AndresMartinM/trebuchet-udd/img/treb02.jpg

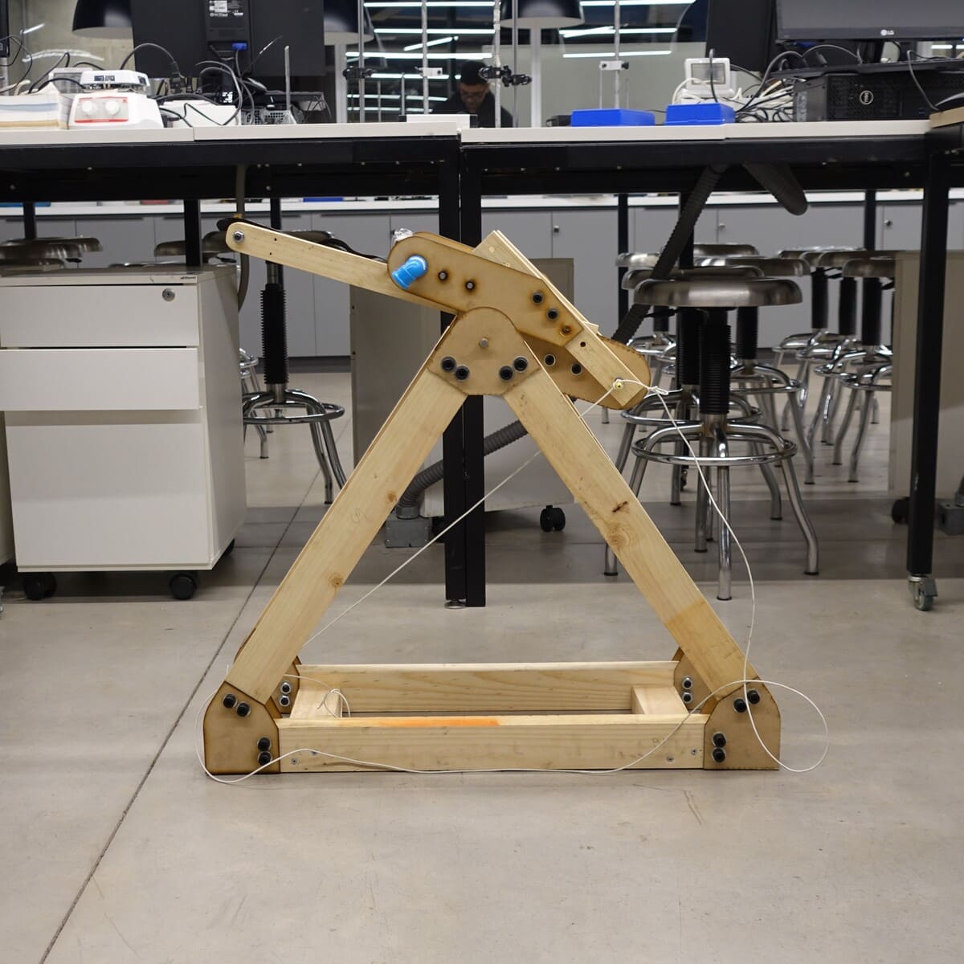
img/treb02.jpg
