AndresMartinM/trebuchet-udd/img/treb03.jpg

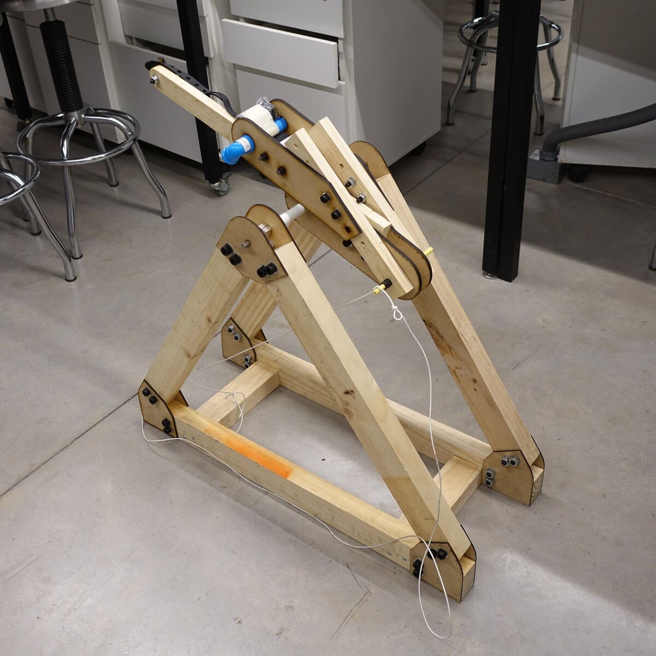
img/treb03.jpg
