AndresMartinM/trebuchet-udd/img/treb04.jpg

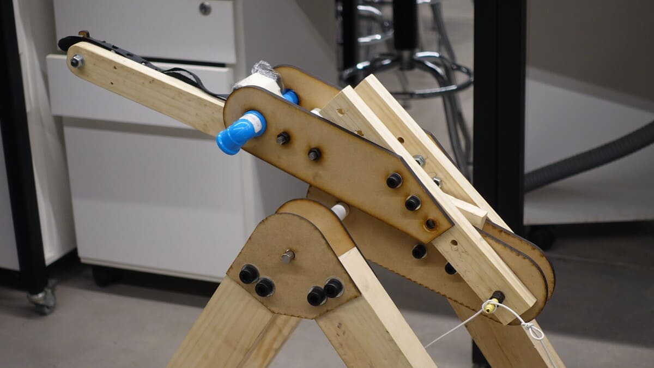
img/treb04.jpg
