AndresMartinM/trebuchet-udd/img/treb05.jpg

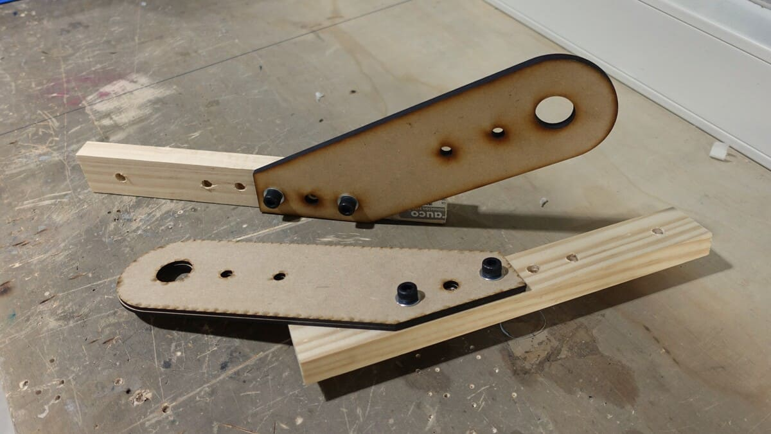
img/treb05.jpg
