AndresMartinM/trebuchet-udd/img/treb06.jpg

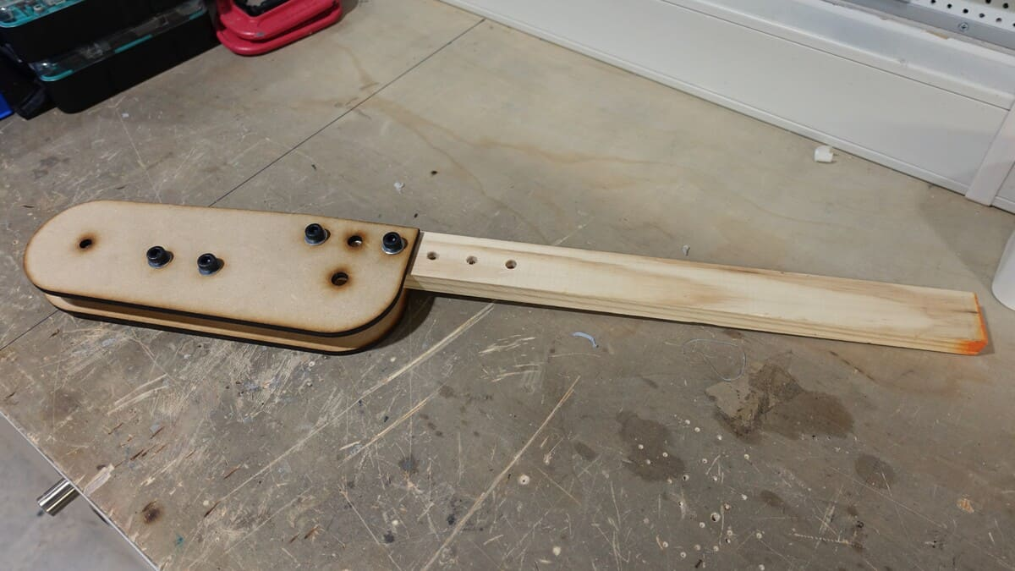
img/treb06.jpg
