AndresMartinM/trebuchet-udd/img/treb07.jpg

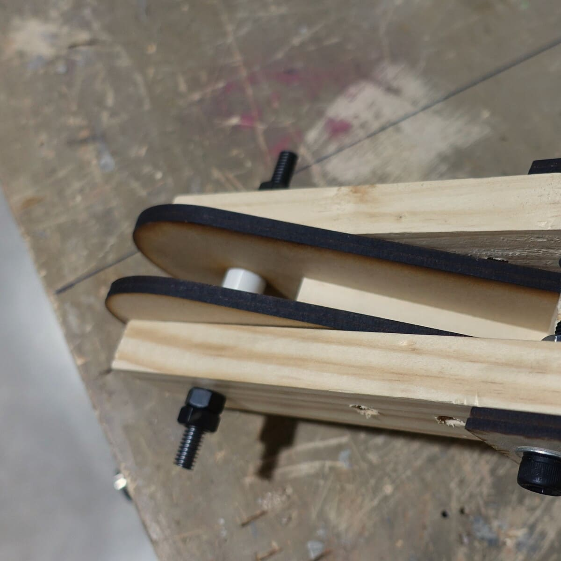
img/treb07.jpg
