AndresMartinM/trebuchet-udd/img/treb08.jpg

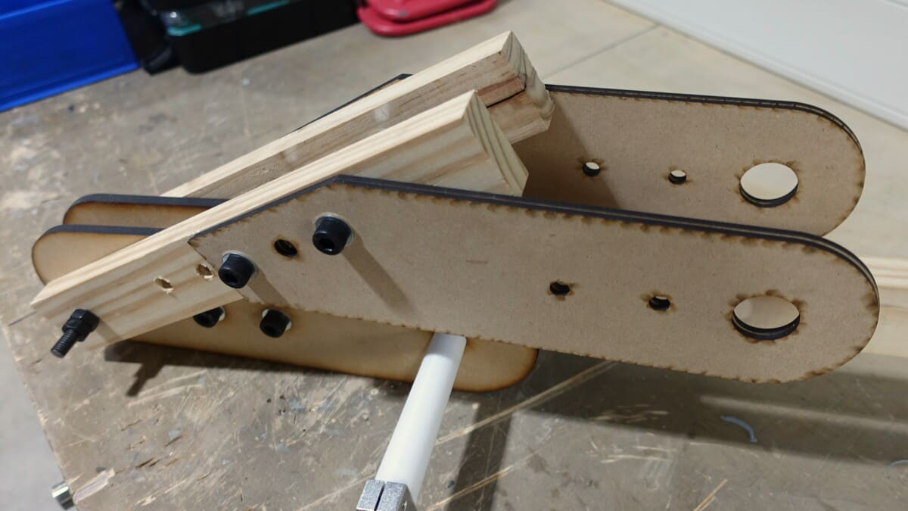
img/treb08.jpg
