AndresMartinM/trebuchet-udd/img/treb09.jpg

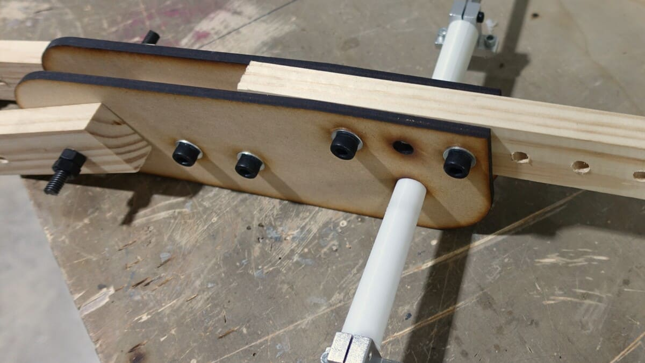
img/treb09.jpg
