AndresMartinM/trebuchet-udd/archivos/cabezalLanzador-1xCatapulta-3Total.stl

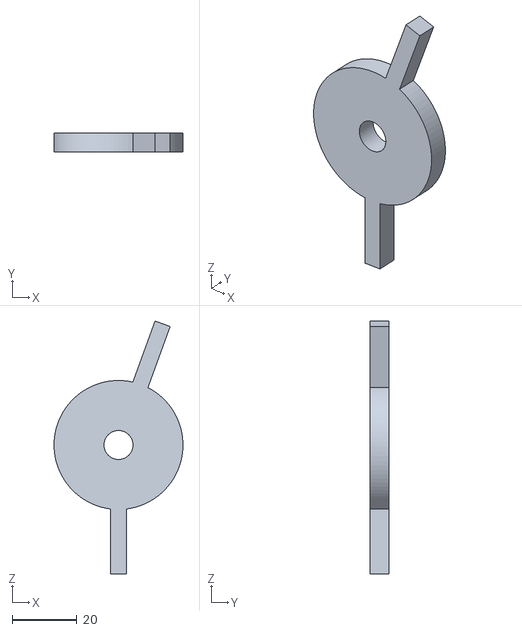
[picture p10: CAD file, 2025-05-27]
archivos/cabezalLanzador-1xCatapulta-3Total.stl
40.0 x 6.00 x 78.4
