AndresMartinM/trebuchet-udd/archivos/CORREGIDOunionSuperiorBaseCatapulta-MDF3mm-8xCatapulta-24Total.dxf

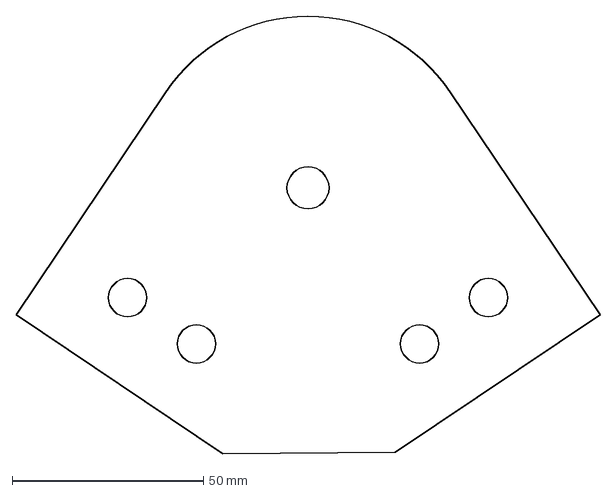
[picture p11: CAD file, 2025-05-27]
archivos/CORREGIDOunionSuperiorBaseCatapulta-MDF3mm-8xCatapulta-24Total.dxf
152.5 x 114.2 mm
