AndresMartinM/trebuchet-udd/archivos/unionBrazoContrapeso-MDF3mm-4xCatapulta-12Total.dxf

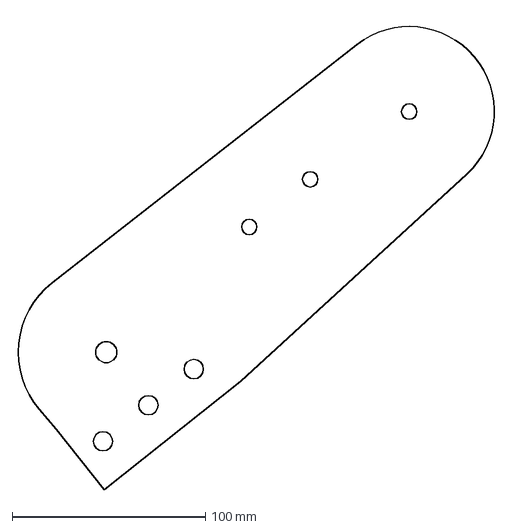
[picture p12: CAD file, 2025-05-27]
archivos/unionBrazoContrapeso-MDF3mm-4xCatapulta-12Total.dxf
252.0 x 244.7 mm
