AndresMartinM/trebuchet-udd/archivos/contrapesoCatapulta-MDF3mm-4xCatapulta-12Total.dxf

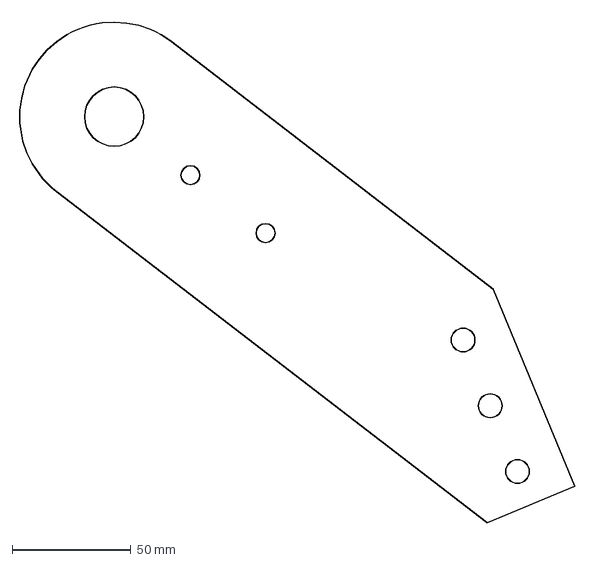
[picture p13: CAD file, 2025-05-27]
archivos/contrapesoCatapulta-MDF3mm-4xCatapulta-12Total.dxf
235.6 x 213.4 mm
