AndresMartinM/trebuchet-udd/archivos/CORREGIDOunionInferiorBaseCatapulta-MDF3mm-16xCatapulta-48Total.dxf

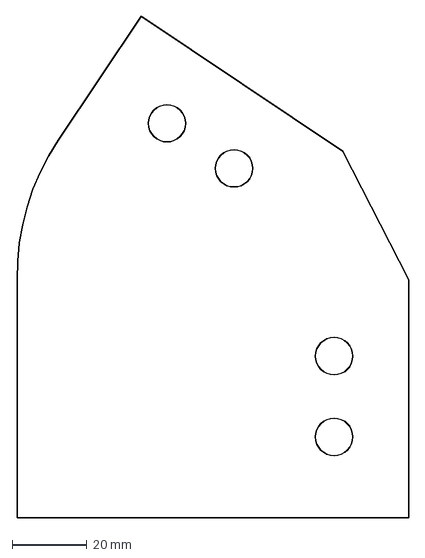
[picture p14: CAD file, 2025-05-27]
archivos/CORREGIDOunionInferiorBaseCatapulta-MDF3mm-16xCatapulta-48Total.dxf
105.2 x 134.4 mm
