AndresMartinM/trebuchet-udd/archivos/separadorEjeCentral-2xCatapulta-6Total.stl

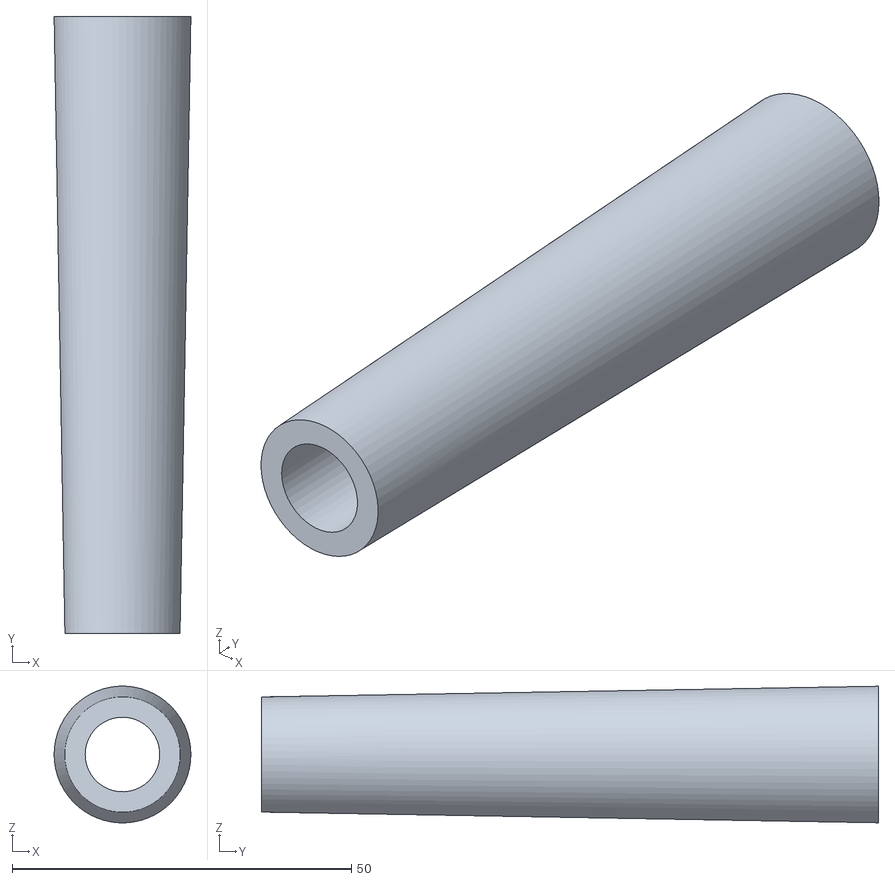
[picture p15: CAD file, 2025-05-27]
archivos/separadorEjeCentral-2xCatapulta-6Total.stl
20.2 x 91.0 x 20.1
