AndresMartinM/trebuchet-udd/archivos/separadorMdfContrapeso-1xCatapulta-3Total.stl

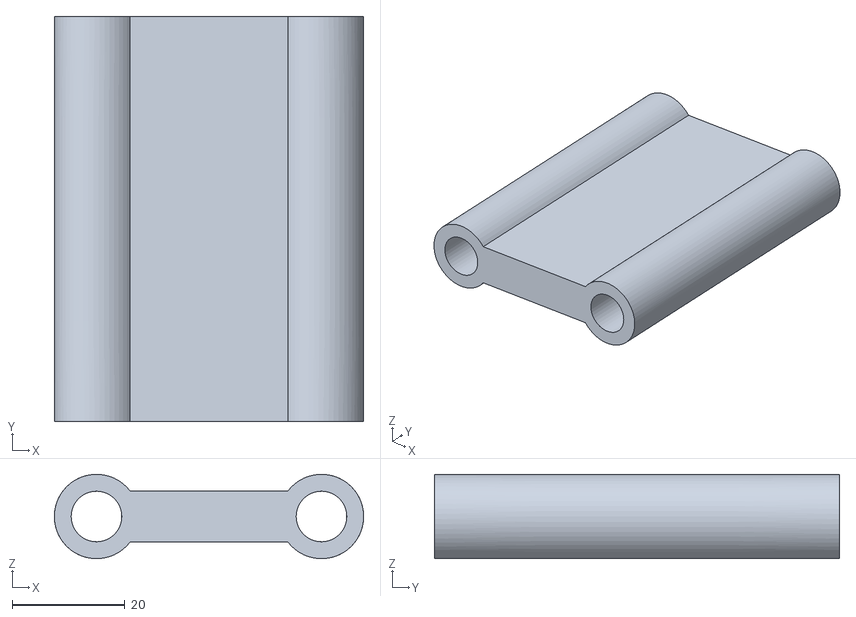
[picture p16: CAD file, 2025-05-27]
archivos/separadorMdfContrapeso-1xCatapulta-3Total.stl
55.0 x 72.0 x 15.0
