AndresMartinM/trebuchet-udd/archivos/separadorEjeContrapeso-1xCatapulta-3Total.stl

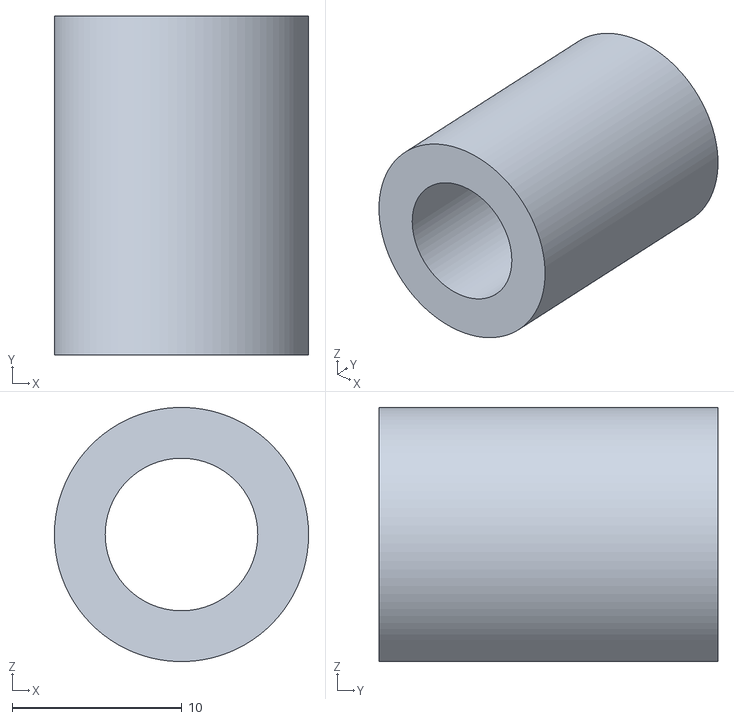
[picture p17: CAD file, 2025-05-27]
archivos/separadorEjeContrapeso-1xCatapulta-3Total.stl
15.0 x 20.0 x 15.0
