AndresMartinM/trebuchet-udd/archivos/ensamble/trebuchetAbril2025-Comps-v14.step

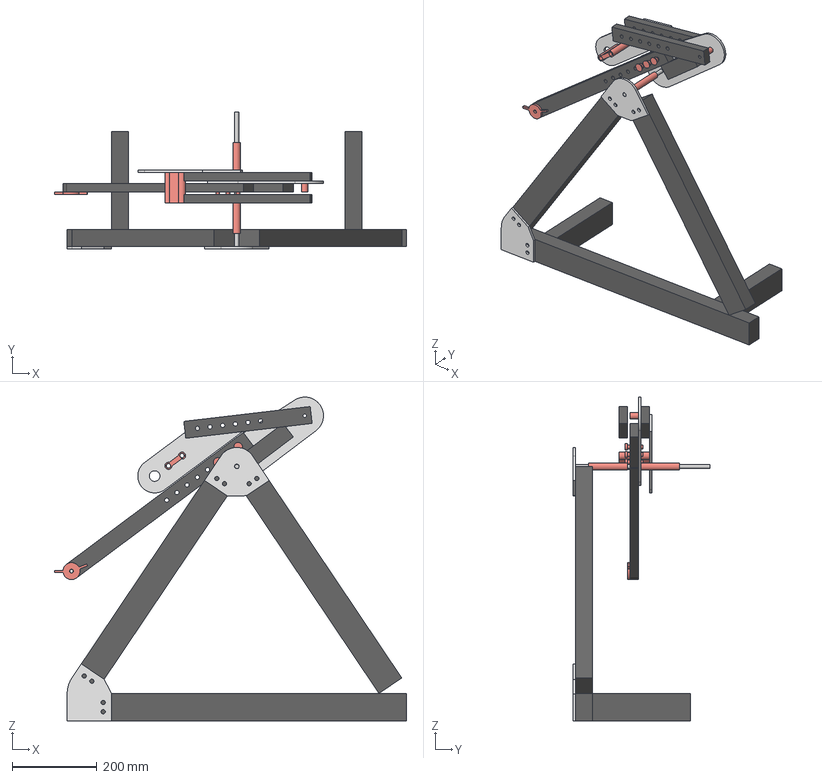
[picture p18: CAD file, 2025-06-04]
archivos/ensamble/trebuchetAbril2025-Comps-v14.step
829.8 x 322.0 x 763.5 mm
MdfCodoContrapeso
PaloUnionMdf
MdfUnionBrazos
BrazoContrapeso x 2
Brazo1
SeparadorEjeContrapeso
topeAjuste
topeAjuste_1
topeAjuste_2
separadorMdfContrapeso
SeparadorEjecentral
SeparadorEjecentral_1
CabezalLanzador
