AndresMartinM/trebuchet-udd/archivos/parcheCatapultaV2-1xCatapulta.dxf

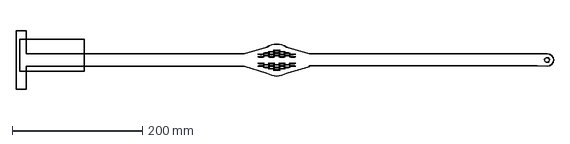
[picture p19: CAD file, 2025-05-27]
archivos/parcheCatapultaV2-1xCatapulta.dxf
823.9 x 89.9 mm
