AndresMartinM/trebuchet-udd/(list of files, cad)

Other CAD files:
archivos/ensamble/trebuchetAbril2025-Comps-v14.f3d
archivos/ensamble/trebuchetAbril2025-Comps-v14.stl
