AndresMartinM/trebuchet-udd/(commit log)

2025-05-27 archivos de fabricación
    [CORREGIDOunionInferiorBaseCatapulta-MDF3mm-16xCatapulta-48Total.dxf, CORREGIDOunionSuperiorBaseCatapulta-MDF3mm-8xCatapulta-24Total.dxf, contrapesoCatapulta-MDF3mm-4xCatapulta-12Total.dxf, parcheCatapultaV2-1xCatapulta.dxf, separadorEjeCentral-2xCatapulta-6Total.stl, separadorEjeContrapeso-1xCatapulta-3Total.stl, separadorMdfContrapeso-1xCatapulta-3Total.stl, unionBrazoContrapeso-MDF3mm-4xCatapul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]
2025-05-27 añadir stl
    [cabezalLanzador-1xCatapulta-3Total.stl]
2025-06-04 agregar archivos de ensamble
    [trebuchetAbril2025-Comps-v14.f3d, trebuchetAbril2025-Comps-v14.step, trebuchetAbril2025-Comps-v14.stl]
